EOSCogniton/Dashboard_controler/Shield carte avant/CANdiy-Shield/hardware/CANdiy-Shield_v13.jpg

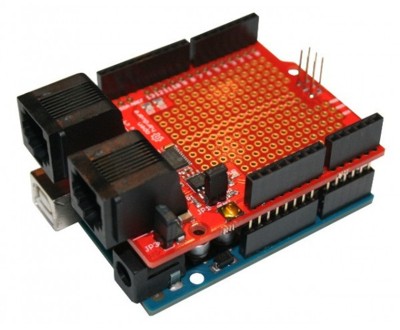
Shield carte avant/CANdiy-Shield/hardware/CANdiy-Shield_v13.jpg
