EOSCogniton/Dashboard_controler/readme.md

# Dashboard controller

* Shield pour Arduino Uno
* Pour le tableau de bord d'OPTIMUS v1.0

## Utilité :
* Transfert le CAN à l'arduino
* Contrôle les boutons lumineux en 12V
* Créer le 5V de puissance pour le tableau de bord
* Permet de se connecter avec des connecteurs molex KK à l'arduino
