EOSCogniton/Dashboard_controler/Shield carte avant/BOM_shield carte avant.xlsx

Qty | Value | Device | Description | Dispo au garage ? | Référence RS |  | oui
2 |  | 2N7000_TO92 | 2N7000, 2N7002, NDS7002A | oui | 671-4733 |  | non
1 |  | SWITCH_PUSHBUTTONEVQ-PE | Buttons | non | 734-6823 |  | Je sais pas
3 | 1 µF | CPOL-EUB45181A | POLARIZED CAPACITOR, European symbol | oui
2 | 100 | R-EU_0204/7 | RESISTOR, European symbol | oui
1 | 100k | R-EU_0204/7 | RESISTOR, European symbol | oui
2 | 10k | R-EU_0204/7 | RESISTOR, European symbol | oui
1 | 120 | R-EU_0204/7 | RESISTOR, European symbol | oui
3 | 1k | R-EU_0204/7 | RESISTOR, European symbol | oui
2 | 22-05-7028-02 | 22-05-7028-02 | CONNECTOR | Je sais pas | 173-2916
1 | 22-05-7038-03 | 22-05-7038-03 | CONNECTOR | Je sais pas | 173-2922
1 | 22-05-7078-07 | 22-05-7078-07 | CONNECTOR | Je sais pas | 173-2972
3 | 27pF | C-EU025-030X050 | CAPACITOR, European symbol | oui
2 | 680 pF | C-EU025-024X044 | CAPACITOR, European symbol | Je sais pas
1 | ARDUINO_R3_ICSP | ARDUINO_R3_ICSP | Arduino Uno | non | 769-7409
1 | FOXSLF_160-20 | FOXSLF_160-20 | Crystal 16.000MHz | non | 547-6294
1 | MCP2515-I_P | MCP2515-I_P | Stand-Alone CAN Controller | non | 628-3532
1 | MCP2562-E_P | MCP2562-E_P | CAN Transceiver | non | 799-0225 | 2N700
1 | THN_15-1211 | THN_15-1211 | TRACOPOWER Isolated DC-DC Converter | non | 438-272
