EOSCogniton/Dashboard_controler/Shield carte avant/CANdiy-Shield/hardware/CANdiy-FD-Shield_v11.pdf

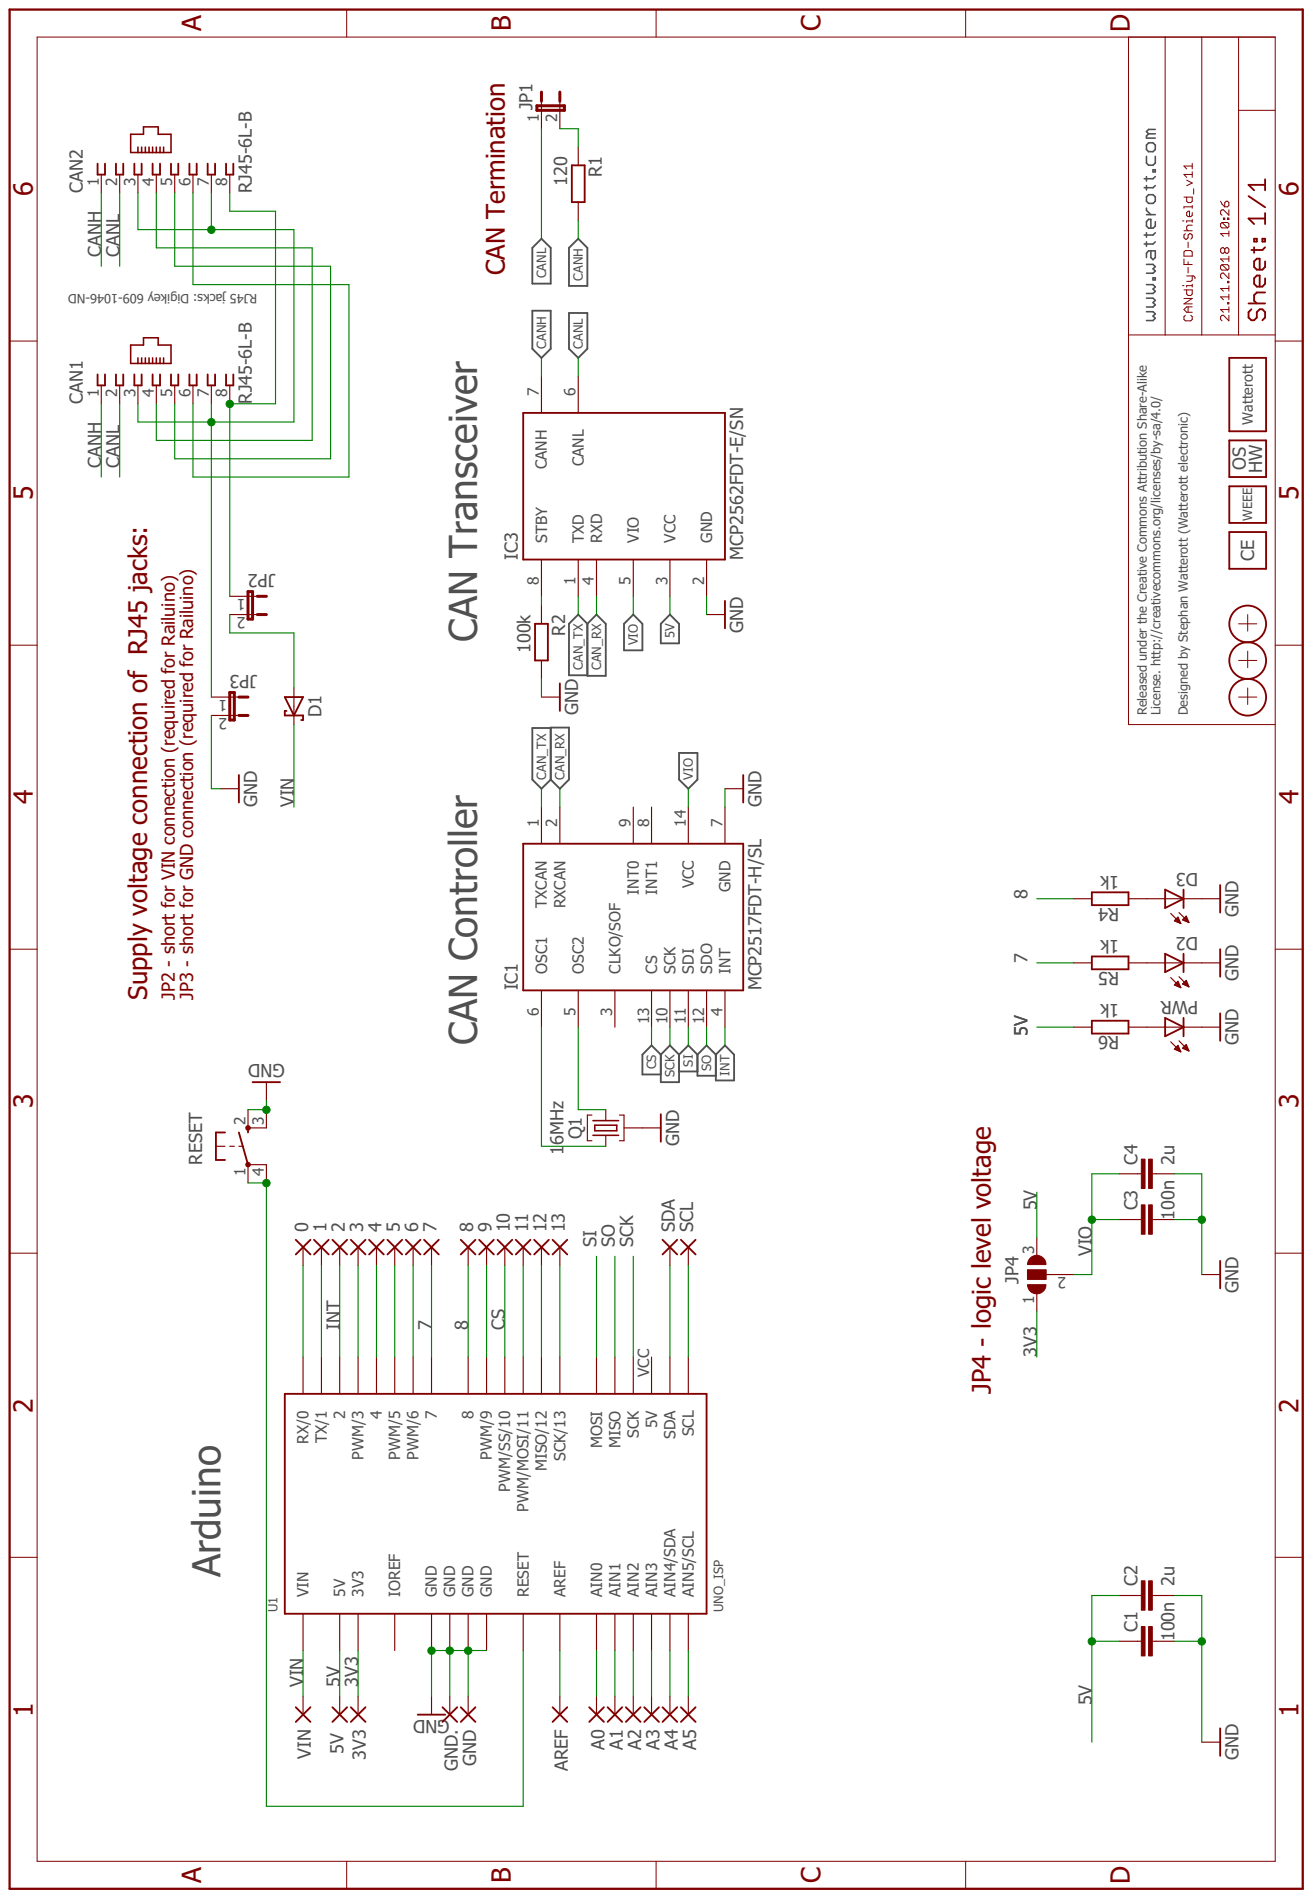
[picture p2: page 1]

DN- 6401- 906 yeki gi D:skcaj 54J RDNG DNG GND 120 RJ45-6L-B RJ45-6L-B 100n 2u GND 100k GND GND k1 GND k1 GND k1 GND 100n GND 2u GND GND 16MHz Released under the Creative Commons Attribution Share-Alike License. http://creativecommons.org/licenses/by-sa/4.0/ Designed by Stephan Watterott (Watterott electronic) Arduino CAN Controller CAN Transceiver RESET 1 23 4 R1 CAN2 12345678 CAN1 12345678 C1 C2 R2 JP1 12 2PJ 123PJ 12 012345678910111213SDA SCL A0A1A2A3A4A5 AREF VIN GND GND. 3V3 3D 4R R WP 6R 2D 5R U1UNO_ISP RX/0 TX/12 AIN0 PWM/34 PWM/5 PWM/678 PWM/9 PWM/SS/10 PWM/MOSI/11 MISO/12 SCK/13 AIN1 AIN2 AIN3 AIN4/SDA AIN5/SCL 5VVIN 3V3 AREF RESET SDA SCL IOREF GND GND GND MOSI MISO SCK GND 5V VCC C3 3 1 2 JP4 C4 Watterott CE OS HW WEEE IC3 MCP2562FDT-E/SN CANH 7 TXD 1 RXD 4 VIO 5 CANL 6 GND 2 VCC 3 STBY 8 IC1 MCP2517FDT-H/SL CS 13 SCK 10 GND 7 VCC 14 SDI 11 SDO 12 OSC2 5 OSC1 6 TXCAN 1 RXCAN 2 CLKO/SOF 3 INT0 9 INT1 8 INT 4 Q1 D1 5V 5V 5V 5V 5V 5V VIN VIN CAN_RX CAN_RX CAN_TX CAN_TX CS CS SCK SCK SI SI SO SO CANCHANH CANH CANH CANL CANL CANL CANL 8 8 INT INT 3V3 3V3 7 7 VIO VIO VIO CAN Termination Supply voltage connection of RJ45 jacks: JP3 - short for GND connection (required for Railuino) JP2 - short for VIN connection (required for Railuino) JP4 - logic level voltage ABCD 1 2 3 4 5 6 ABCD 1 2 3 4 5 6

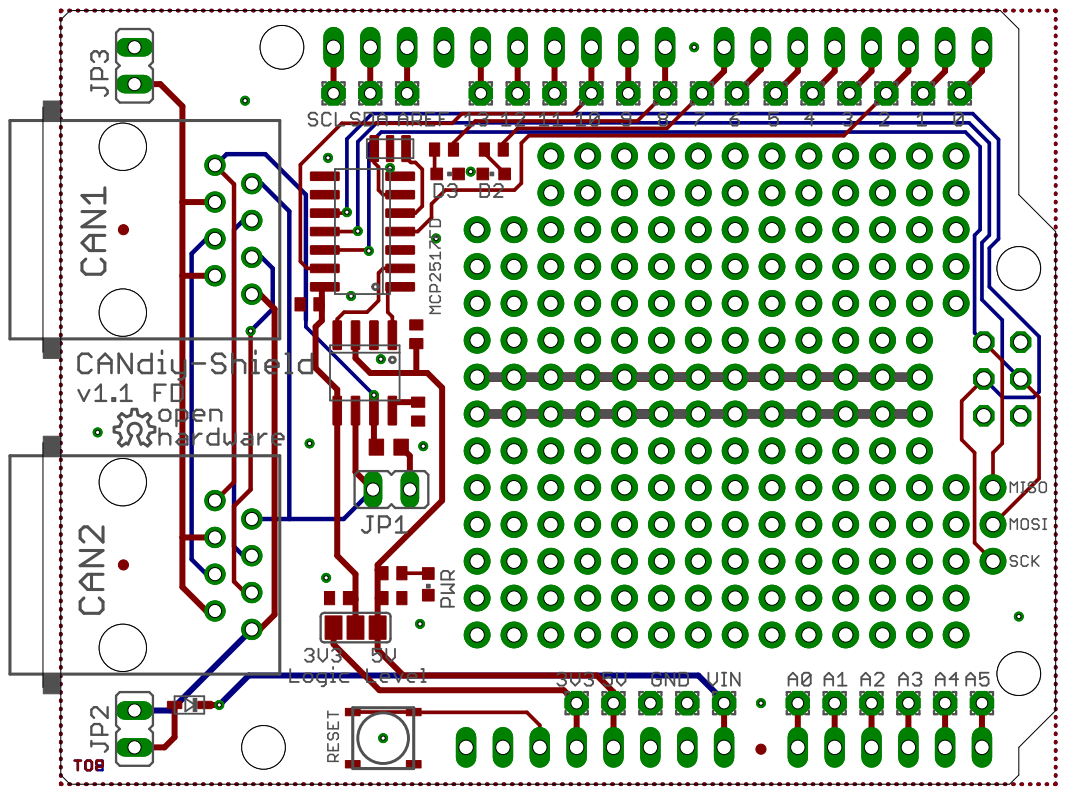
[picture p3: page 2]
