EOSCogniton/Dashboard_controler/Shield carte avant/CANdiy-Shield/hardware/CANdiy-Shield_v20.pdf

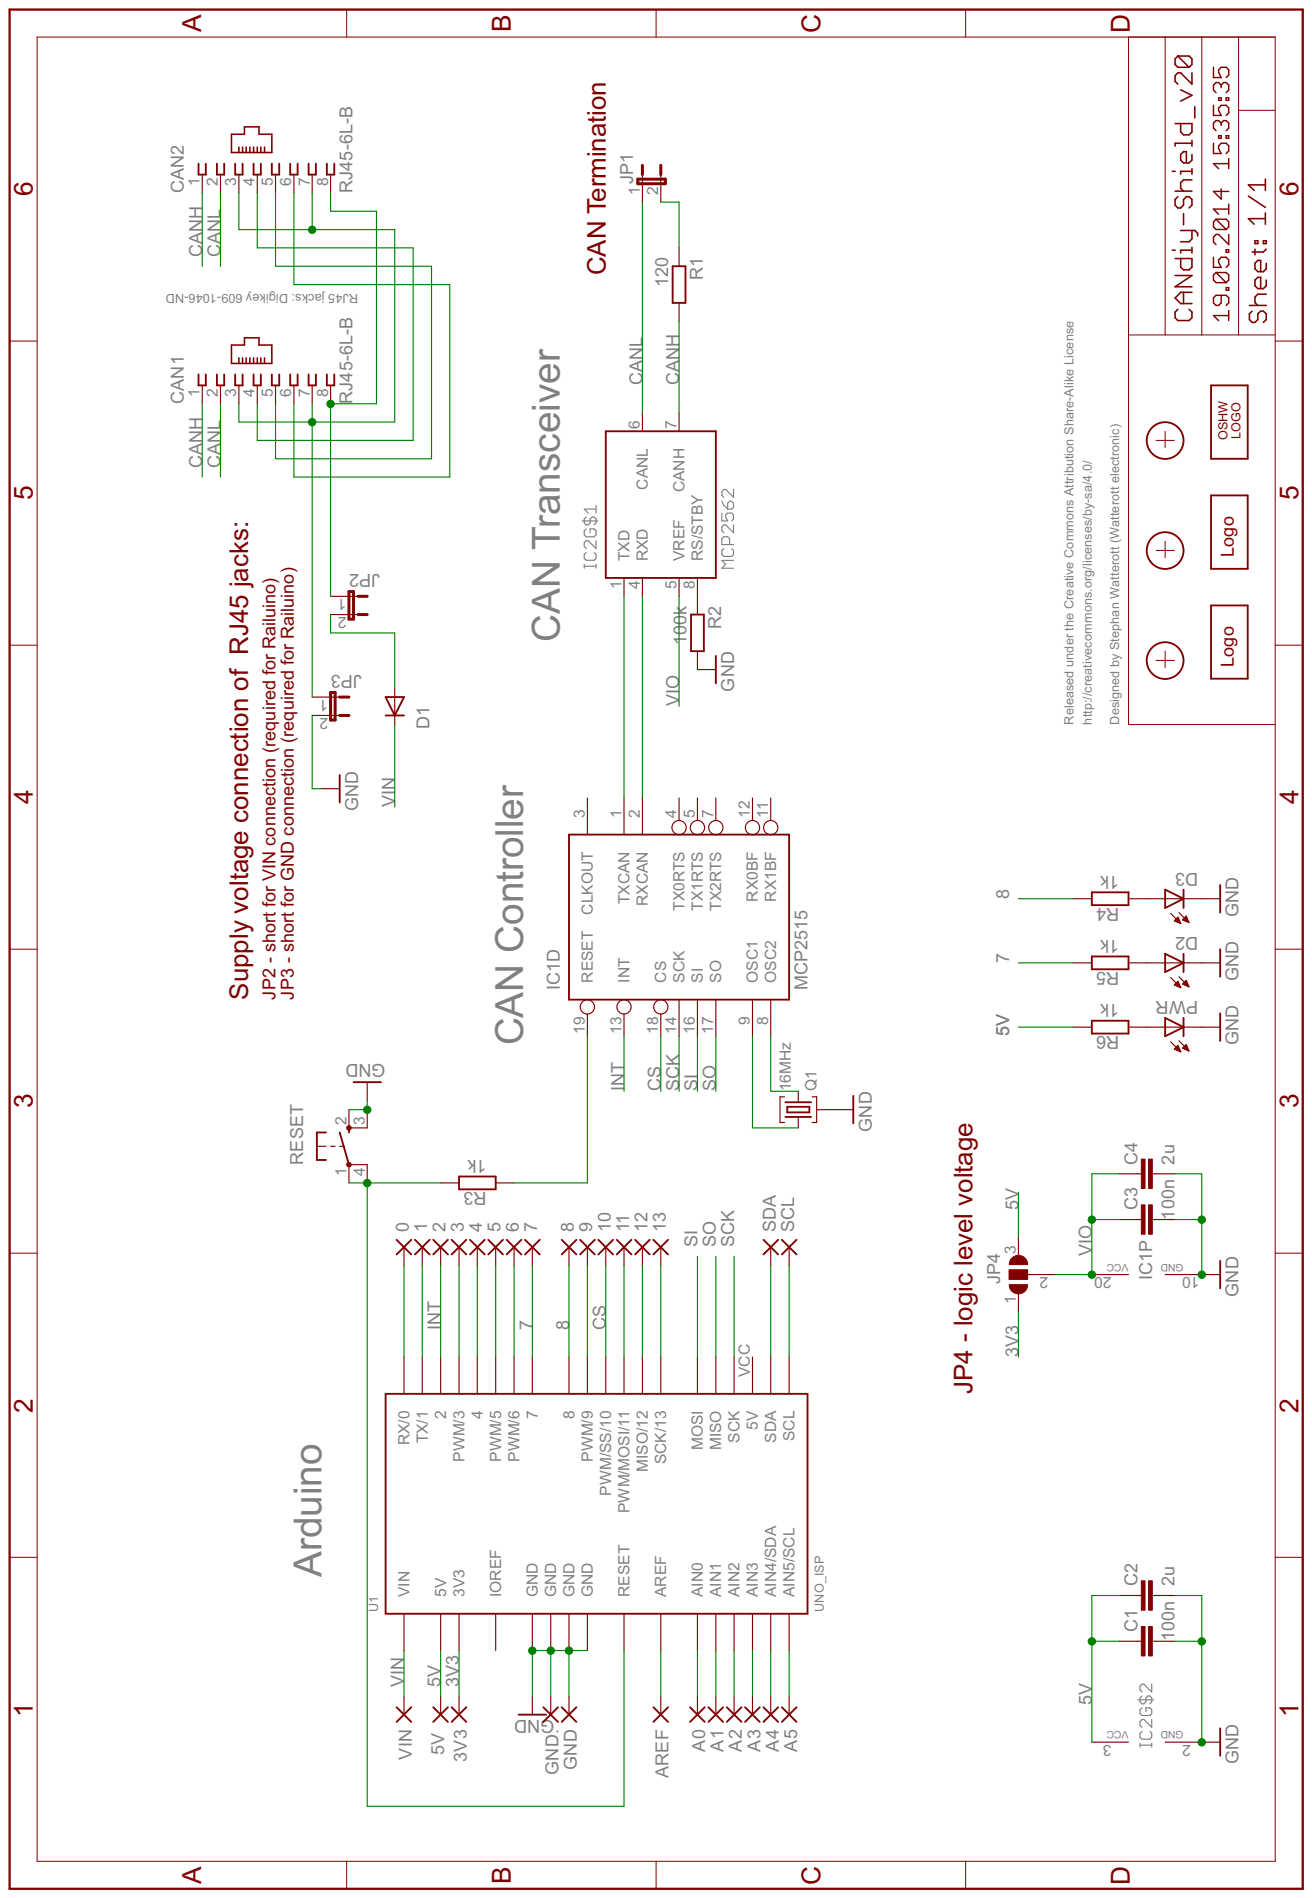
[picture p4: page 1]

DN- 6401- 906 yeki gi D: skcaj 54J RDNG DNG GND 120 RJ45-6L-B RJ45-6L-B 100n 2u GND 100k GND GNDk1 GNDk1 GNDk1 GND 16MHz MCP2515 100n GND 2uk1 Released under the Creative Commons Attribution Share-Alike License http://creativecommons.org/licenses/by-sa/4.0/ Designed by Stephan Watterott (Watterott electronic) Arduino CAN Controller CAN Transceiver /STBY RESET 1 23 4 CANH 7 CANL 6 RS 8 RXD 4 TXD 1 VREF 5 CCV DNG 3 2 R1 CAN2 12345678 CAN1 12345678 C1 C2 R2 JP1 12 2PJ 123PJ 12 012345678910111213SDA SCL A0A1A2A3A4A5 AREF VIN GND GND. 3V3 3D 4R R WP 6R 2D 5R D1 U1 UNO_ISP RX/0 TX/12 AIN0 PWM/34 PWM/5 PWM/678 PWM/9 PWM/SS/10 PWM/MOSI/11 MISO/12 SCK/13 AIN1 AIN2 AIN3 AIN4/SDA AIN5/SCL 5VVIN 3V3 AREF RESET SDA SCL IOREF GND GND GND MOSI MISO SCK GND 5V VCC Q1 IC1D CLKOUT 3 CS 18 INT 13 OSC1 9 OSC2 8 RESET 19 RX0BF 12 RX1BF 11 RXCAN 2 SCK 14 SI 16 SO 17 TX0RTS 4 TX1RTS 5 TX2RTS 7 TXCAN 1 CCV DNG IC1P 02 01 C3 3 1 2 JP4 C4 3R 5V 5V 5V 5V 5V VIN VIN CS CS SCK SCK SI SI SO SO CANH CANH CANH CANL CANL CANL 8 8 INT INT 3V3 3V3 7 7 VIO VIO CAN Termination Supply voltage connection of RJ45 jacks: JP3 - short for GND connection (required for Railuino) JP2 - short for VIN connection (required for Railuino) JP4 - logic level voltage ABCD 1 2 3 4 5 6 ABCD 1 2 3 4 5 6 OSHW LOGO Logo Logo

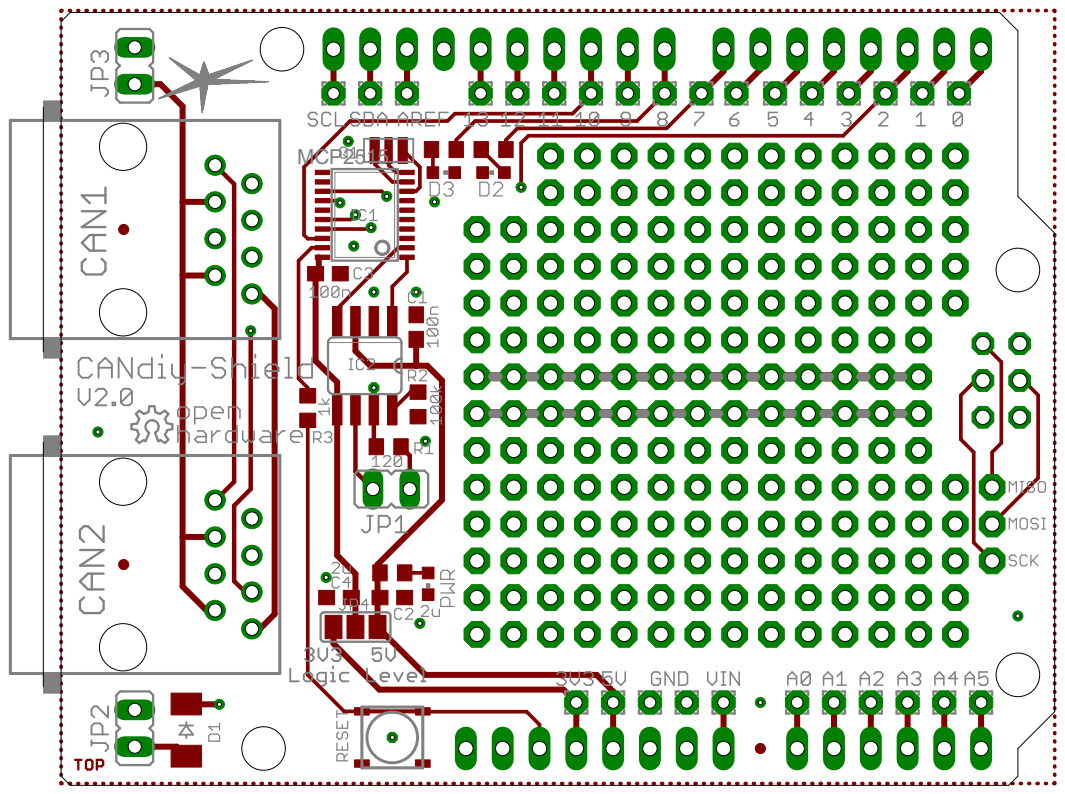
[picture p5: page 2]
MCP2515

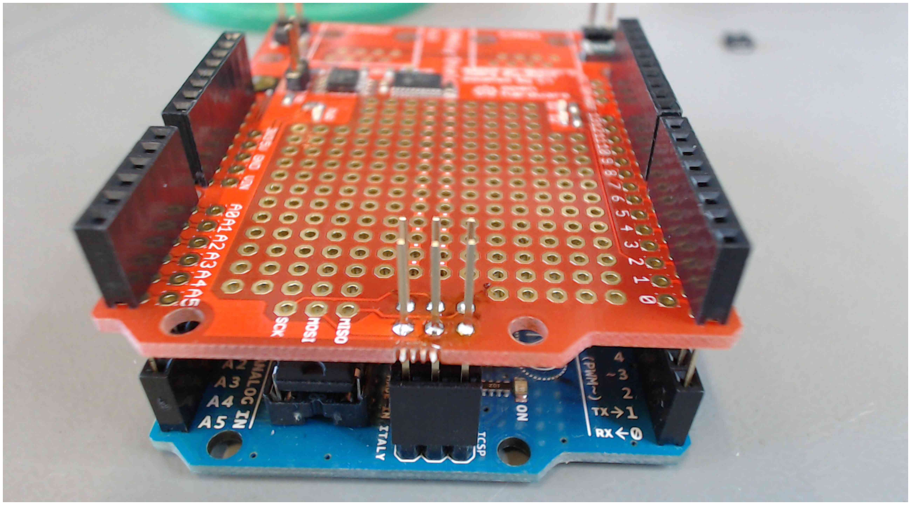
[picture p6: figure]
