EOSCogniton/Dashboard_controler/Shield carte avant/CANdiy-Shield/hardware/CANdiy-Shield_v12.pdf

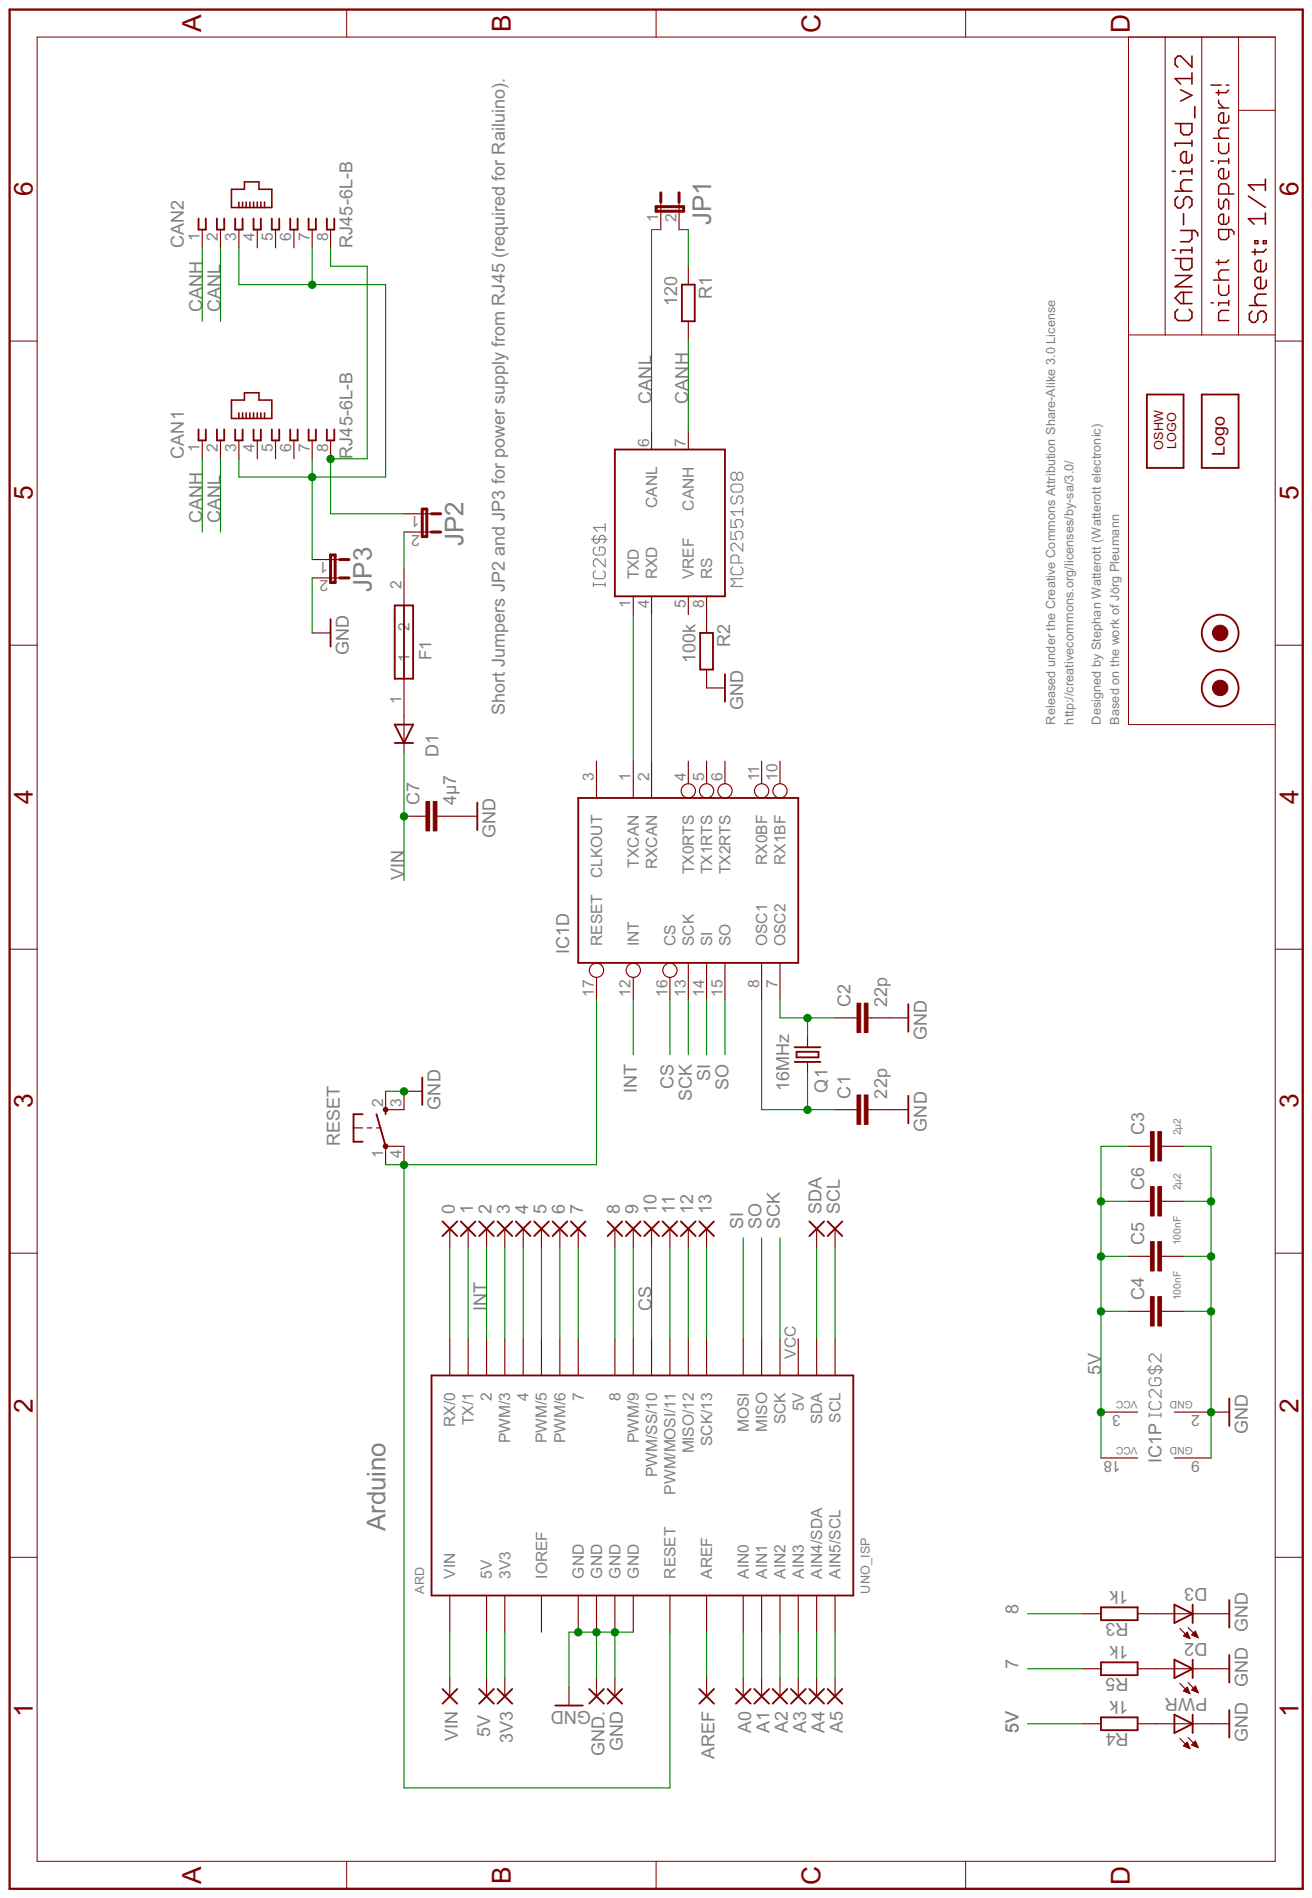
[picture p7: page 1]

GND GND 120 RJ45-6L-B RJ45-6L-B 16MHz 22p 22p 2µ2 100nF 100nF 2µ2 GND GND 100k GND DNG GNDk1 GNDk1 GNDk1 4µ7 GND GND Released under the Creative Commons Attribution Share-Alike 3.0 License http://creativecommons.org/licenses/by-sa/3.0/ Designed by Stephan Watterott (Watterott electronic) Arduino F1 Based on the work of Jörg Pleumann RESET 1 23 4 IC1D CLKOUT 3 CS 16 INT 12 OSC1 8 OSC2 7 RESET 17 RX0BF 11 RX1BF 10 RXCAN 2 SCK 13 SI 14 SO 15 TX0RTS 4 TX1RTS 5 TX2RTS 6 TXCAN 1 CANH 7 CANL 6 RS 8 RXD 4 TXD 1 VREF 5 CCV DNG 3 2 R1 CAN2 12345678 CAN1 12345678 Q1 C1 C2 C3 C4 C5 C6 CCV DNG IC1P 81 9 R2 12JP1 12 JP2 12 JP3 012345678910111213SDA SCL A0A1A2A3A4A5 AREF VIN GND GND. 3V3 3D 3R R WP 4R 2D 5R C7 D1 1 1 2 2 ARD UNO_ISP RX/0 TX/12 AIN0 PWM/34 PWM/5 PWM/678 PWM/9 PWM/SS/10 PWM/MOSI/11 MISO/12 SCK/13 AIN1 AIN2 AIN3 AIN4/SDA AIN5/SCL 5VVIN 3V3 AREF RESET SDA SCL IOREF GND GND GND MOSI MISO SCK GND 5V VCC 5V 5V 5V VIN CS CS SCK SCK SI SI SO SO CANH CANH CANH CANL CANL CANL 8 INT INT 7 ABCD 1 2 3 4 5 6 ABCD 1 2 3 4 5 6 OSHW LOGO Logo Short Jumpers JP2 and JP3 for power supply from RJ45 (required for Railuino).

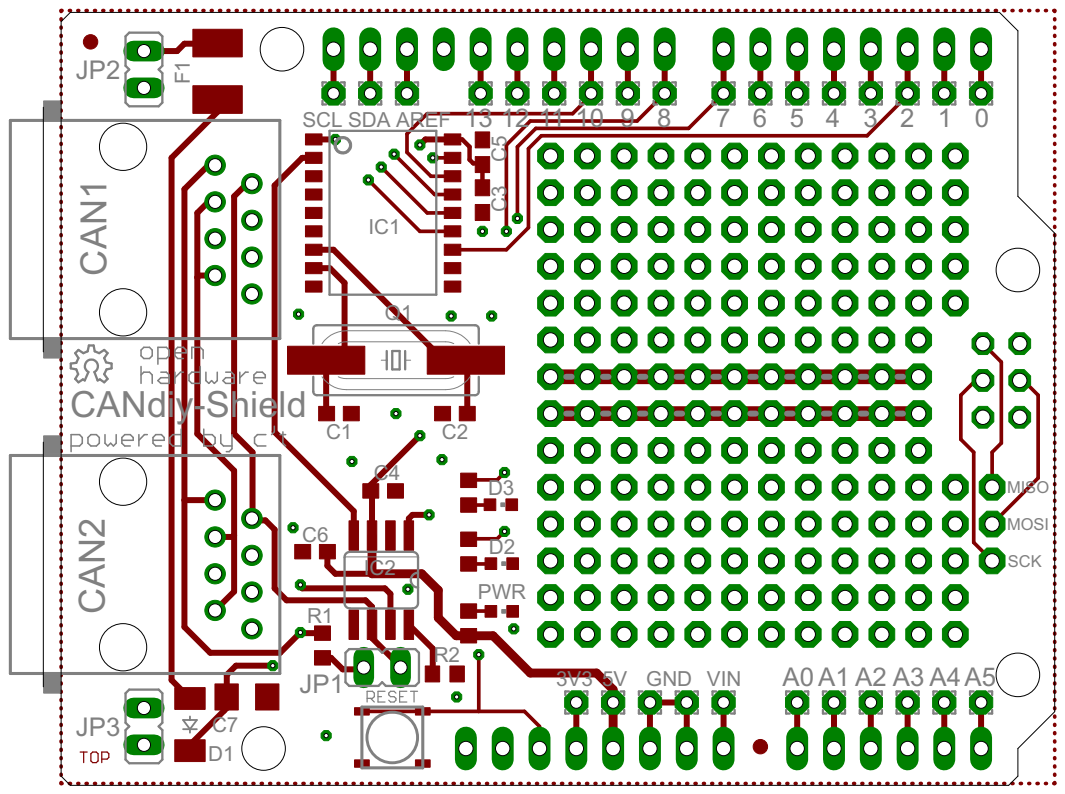
[picture p8: page 2]
