EOSCogniton/Dashboard_controler/Shield carte avant/shield carte avant.brd

## EAGLE design Shield carte avant/shield carte avant.brd (2019-01-17)

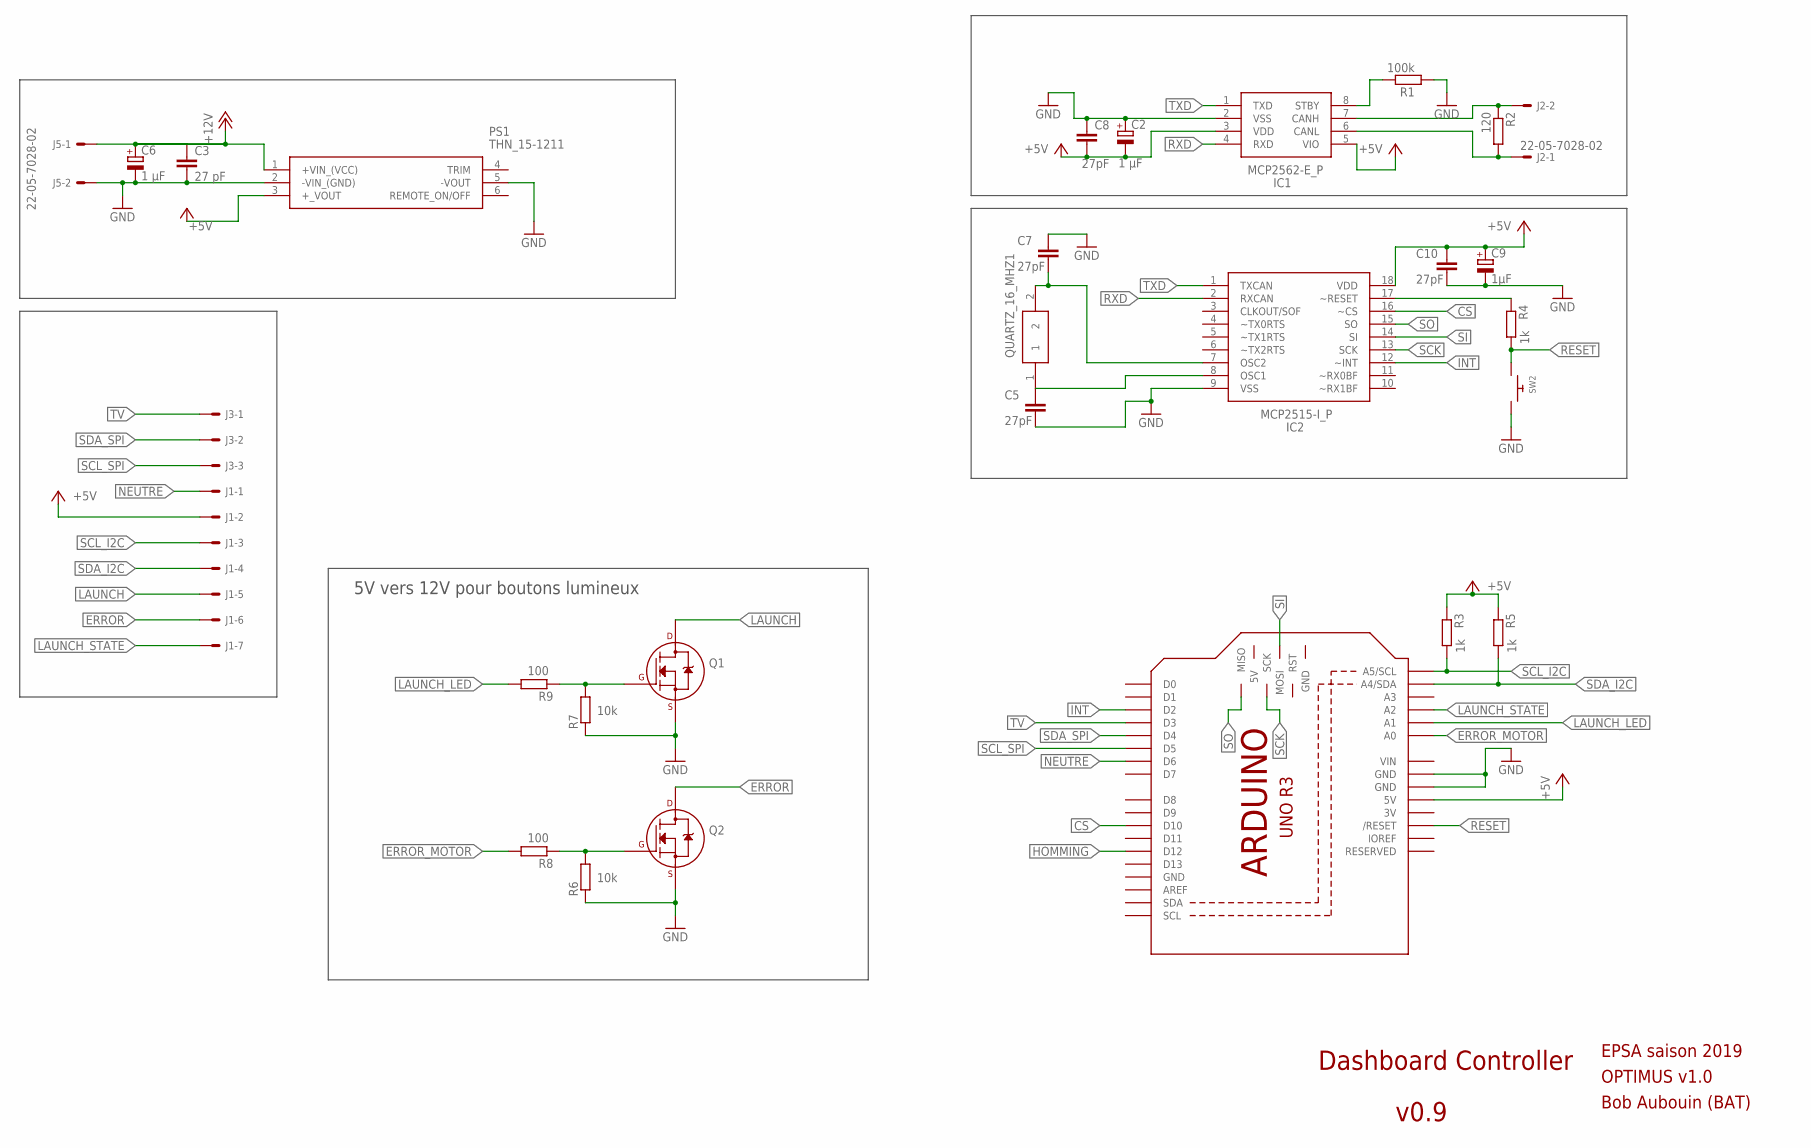
[picture p9: schematic shield carte avant.sch]

Parts:
C2, C6: 1 µF; B45181A
C3: 27 pF; C025-024X044
C5, C7, C8, C10: 27pF; C025-030X050
C9: 1µF; B45181A
IC1: MCP2562-E_P; DIP781W56P254L950H533Q8N
IC2: MCP2515-I_P; DIP254P762X432-18
J1: 22-05-7078-07; 7395-07
J2, J5: 22-05-7028-02; 7395-02
J3: 22-05-7038-03; 7395-03
M1: ARDUINO_R3_ICSP; ARDUINOR3_ICSP
PS1: THN_15-1211; THN-15-SERIES
Q1, Q2: 2N7000_TO92; TO-92
QUARTZ_16_MHZ1: FOXSLF_160-20; HC49SLF_1
R1: 100k; 0204/7
R2: 120; 0204/7
R3, R4, R5: 1k; 0204/7
R6, R7: 10k; 0204/7
R8, R9: 100; 0204/7
SW2: SWITCH_PUSHBUTTONEVQ-PE; TACT_PANA-EVQ

Connections:
3V: M1.3V
+5V: C2.-, C8.2, C9.+, C10.1, IC1.3 (VDD), IC2.18 (VDD), J1.2, M1.5V, PS1.3 (+_VOUT), R3.1, R5.1
+12V: C3.1, C6.+, J5.1, PS1.1 (+VIN_(VCC))
CS: IC2.16 (~CS), M1.D10
ERROR: J1.6, Q2.3 (D)
ERROR_MOTOR: M1.A0, R8.2
GND: C2.+, C3.2, C5.2, C6.-, C7.1, C8.1, C9.-, C10.2, IC1.2 (VSS), IC2.9 (VSS), J5.2, M1.GND, M1.GND@1 (GND), M1.GND@3 (GND), PS1.2 (-VIN_(GND)), PS1.5 (-VOUT), Q1.1 (S), Q2.1 (S), R1.1, R6.1, R7.1, SW2.P$2
HOMMING: M1.D12
INT: IC2.12 (~INT), M1.D2
LAUNCH: J1.5, Q1.3 (D)
LAUNCH_LED: M1.A1, R9.2
LAUNCH_STATE: J1.7, M1.A2
unnamed: IC1.8 (STBY), R1.2
unnamed: C5.1, IC2.8 (OSC1), QUARTZ_16_MHZ1.1
unnamed: IC1.7 (CANH), J2.2, R2.1
unnamed: C7.2, IC2.7 (OSC2), QUARTZ_16_MHZ1.2
unnamed: IC1.6 (CANL), J2.1, R2.2
unnamed: IC2.17 (~RESET), R4.1
unnamed: Q2.2 (G), R6.2, R8.1
unnamed: Q1.2 (G), R7.2, R9.1
NEUTRE: J1.1, M1.D6
RESET: M1.RESET (/RESET), R4.2, SW2.P$1
RXD: IC1.4 (RXD), IC2.2 (RXCAN)
SCK: IC2.13 (SCK), M1.SCK
SCL_I2C: J1.3, M1.A5 (A5/SCL), R3.2
SCL_SPI: J3.3, M1.D5
SDA_I2C: J1.4, M1.A4 (A4/SDA), R5.2
SDA_SPI: J3.2, M1.D4
SI: IC2.14 (SI), M1.MOSI
SO: IC2.15 (SO), M1.MISO
TV: J3.1, M1.D3
TXD: IC1.1 (TXD), IC2.1 (TXCAN)
VIN: M1.VIN

Notes on the sheet:
Dashboard Controller
v0.9
EPSA saison 2019
OPTIMUS v1.0
Bob Aubouin (BAT)
5V vers 12V pour boutons lumineux

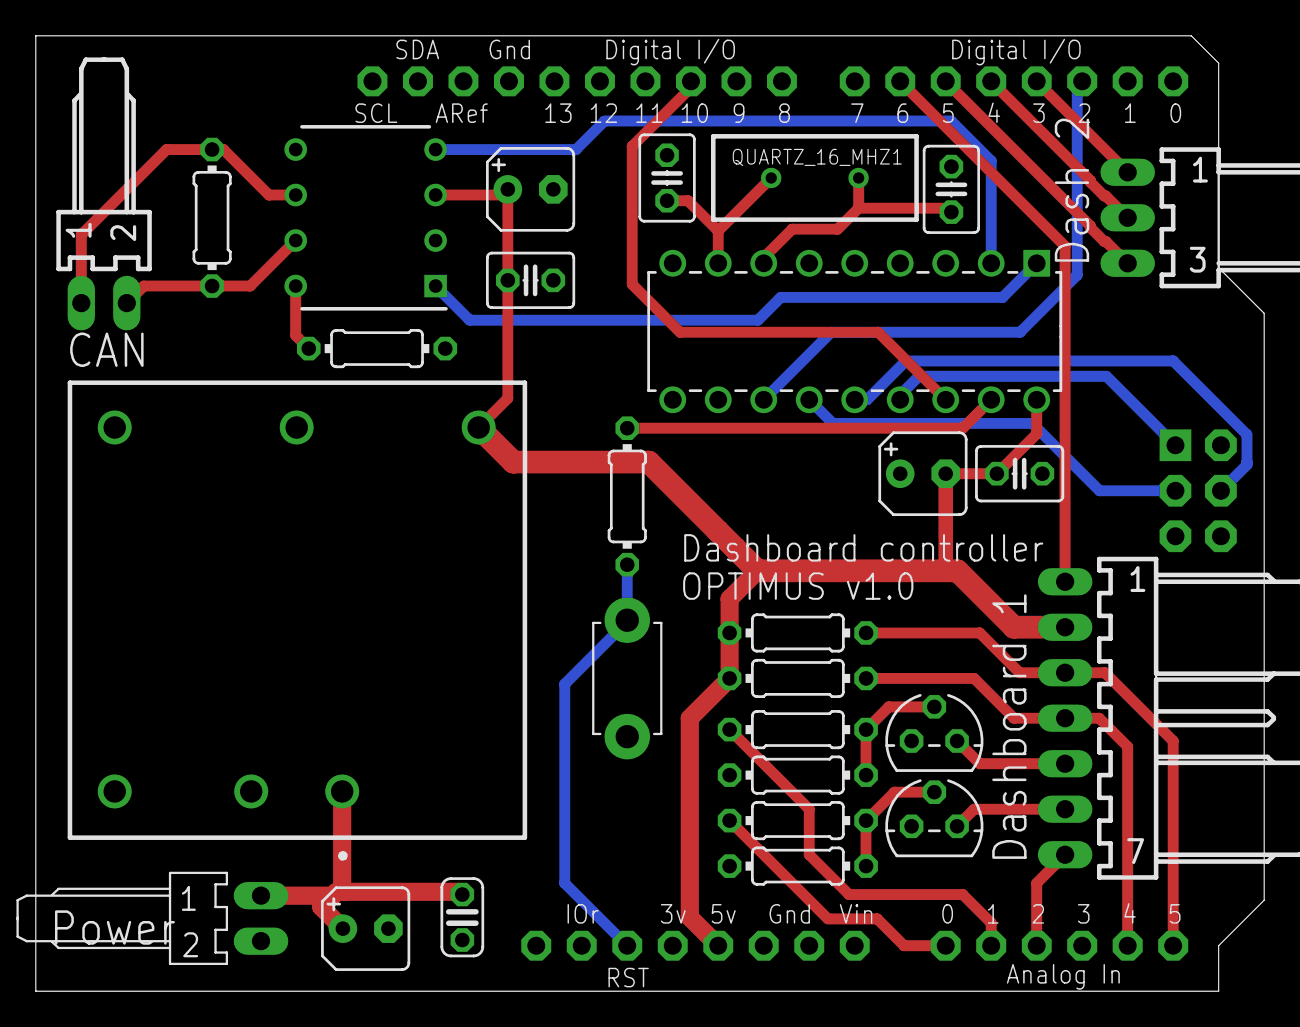
[picture p10: board shield carte avant.brd from above]

Board: 2 copper layers, 68.6 x 53.3 mm, 29 parts (0 on the bottom side), 30 nets.
