EOSCogniton/Dashboard_controler/Shield carte avant/CANdiy-Shield/hardware/CANdiy-FD-Shield_v11.brd

## EAGLE design Shield carte avant/CANdiy-Shield/hardware/CANdiy-FD-Shield_v11.brd (2019-01-17)

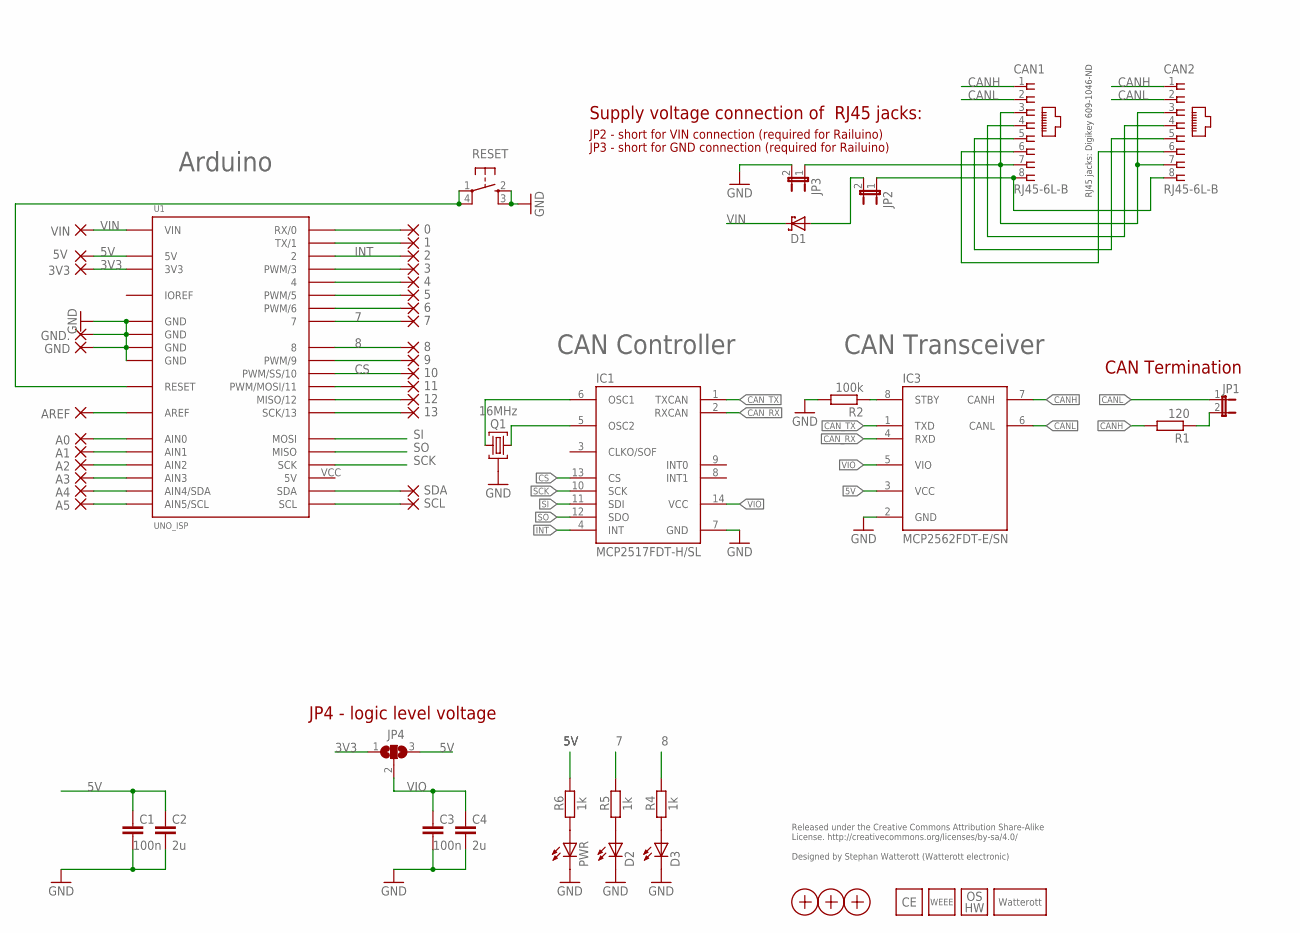
[picture p11: schematic CANdiy-FD-Shield_v11.sch]

Parts:
0, 1, 2, 3, 3V3, 4, 5, 5V, 6, 7, 8, 9, 10, 11, 12, 13: 1,6/0,8
A0, A1, A2, A3, A4, A5: 1,6/0,8
AREF: 1,6/0,8
C1, C3: 100n; C0402
C2, C4: 2u; C0402
CAN1, CAN2: RJ45-6L-B; RJ45-NO-SHIELD
D1: D_SCHOTTKY-SOD323; SOD323
D2, D3: LEDCHIPLED_0603; CHIPLED_0603
GND, GND.: 1,6/0,8
IC1: MCP2517FDT-H/SL; SO14
IC3: MCP2562FDT-E/SN; SO08
JP1, JP2, JP3: JP1E; JP1
JP4: SJ2W; SJ_2
LOGO3: LOGO-9; LOGO_9MM
LOGO4: LOGO_CE-2; CE_2MM
LOGO5: LOGO_OSHW-3; OSHW_3MM
LOGO6: LOGO_WEEE-4; WEEE_4MM
PWR: LEDCHIPLED_0603; CHIPLED_0603
Q1: 16MHz; CRYSTAL_32X13
R1: 120; R0603
R2: 100k; R0402
R4, R5, R6: 1k; R0402
RESET: SW_SMDS; SW_SMD4
SCL: 1,6/0,8
SDA: 1,6/0,8
U1: UNO_ISP
VIN: 1,6/0,8
X1, X2, X3: PASSER-07; PASSER_07MM

Connections:
0: 0.1, U1.0 (RX/0)
1: 1.1, U1.1 (TX/1)
3: 3.1, U1.3 (PWM/3)
3V3: 3V3.1, JP4.1, U1.3V3
4: 4.1, U1.4
5: 5.1, U1.5 (PWM/5)
5V: 5V.1, C1.1, C2.1, IC3.3 (VCC), JP4.3, R6.1, U1.5V
6: 6.1, U1.6 (PWM/6)
7: 7.1, R5.1, U1.7
8: 8.1, R4.1, U1.8
9: 9.1, U1.9 (PWM/9)
11: 11.1, U1.11 (PWM/MOSI/11)
12: 12.1, U1.12 (MISO/12)
13: 13.1, U1.13 (SCK/13)
A0: A0.1, U1.AIN0
A1: A1.1, U1.AIN1
A2: A2.1, U1.AIN2
A3: A3.1, U1.AIN3
A4: A4.1, U1.AIN4 (AIN4/SDA)
A5: A5.1, U1.AIN5 (AIN5/SCL)
AREF: AREF.1, U1.AREF
CANH: CAN1.1, CAN2.1, IC3.7 (CANH), R1.2
CANL: CAN1.2, CAN2.2, IC3.6 (CANL), JP1.1
CAN_RX: IC1.2 (RXCAN), IC3.4 (RXD)
CAN_TX: IC1.1 (TXCAN), IC3.1 (TXD)
CS: 10.1, IC1.13 (CS), U1.10 (PWM/SS/10)
GND: C1.2, C2.2, C3.2, C4.2, D2.C, D3.C, GND.1, GND..1, IC1.7 (GND), IC3.2 (GND), JP3.2, PWR.C, Q1.GND, R2.2, RESET.2 (S), RESET.3 (S1), U1.GND@1 (GND), U1.GND@2 (GND), U1.GND@3 (GND), U1.GND@4 (GND)
INT: 2.1, IC1.4 (INT), U1.2
IOREF: U1.IOREF
unnamed: CAN1.8, CAN2.8, JP2.1
unnamed: IC3.8 (STBY), R2.1
unnamed: CAN1.3, CAN1.7, CAN2.3, CAN2.7, JP3.1
unnamed: JP1.2, R1.1
unnamed: SCL.1, U1.SCL
unnamed: SDA.1, U1.SDA
unnamed: D3.A, R4.2
unnamed: PWR.A, R6.2
unnamed: D2.A, R5.2
unnamed: D1.A, JP2.2
unnamed: CAN1.4, CAN2.4
unnamed: CAN1.5, CAN2.5
unnamed: CAN1.6, CAN2.6
OSC1: IC1.6 (OSC1), Q1.2
OSC2: IC1.5 (OSC2), Q1.1
RESET: RESET.1, RESET.4 (P1), U1.RST (RESET)
SCK: IC1.10 (SCK), U1.SCK
SI: IC1.11 (SDI), U1.MOSI
SO: IC1.12 (SDO), U1.MISO
VIN: D1.C, U1.VIN, VIN.1
VIO: C3.1, C4.1, IC1.14 (VCC), IC3.5 (VIO), JP4.2

Notes on the sheet:
Released under the Creative Commons Attribution Share-Alike License. http://creativecommons.org/licenses/by-sa/4.0/ Designed by Stephan Watterott (Watterott electronic)
Arduino
CAN Termination
Supply voltage connection of RJ45 jacks:
JP3 - short for GND connection (required for Railuino)
JP2 - short for VIN connection (required for Railuino)
RJ45 jacks: Digikey 609-1046-ND
CAN Controller
CAN Transceiver
JP4 - logic level voltage

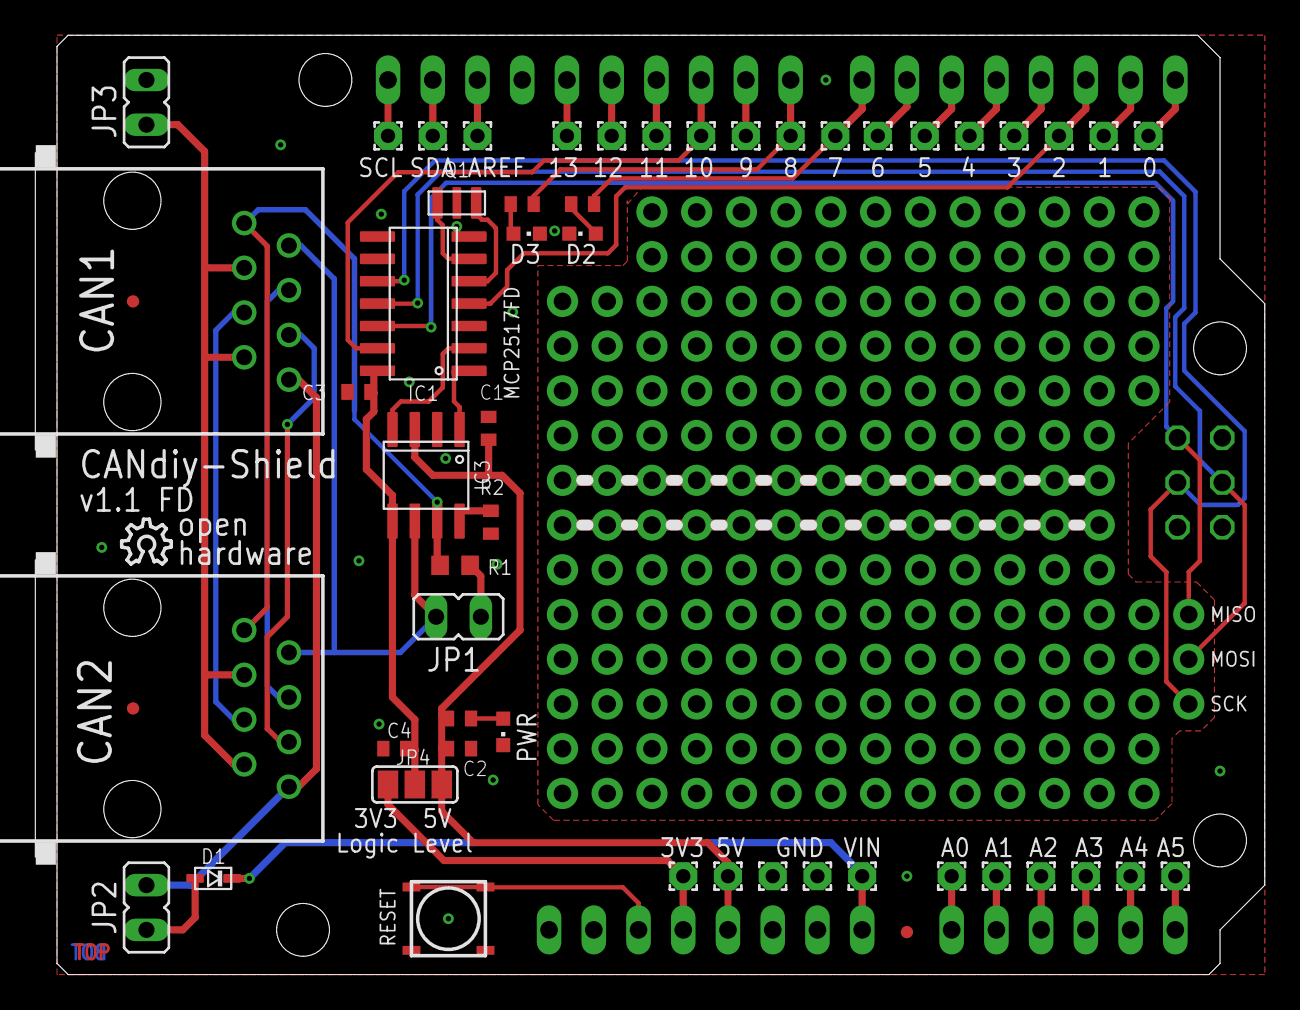
[picture p12: board CANdiy-FD-Shield_v11.brd from above]

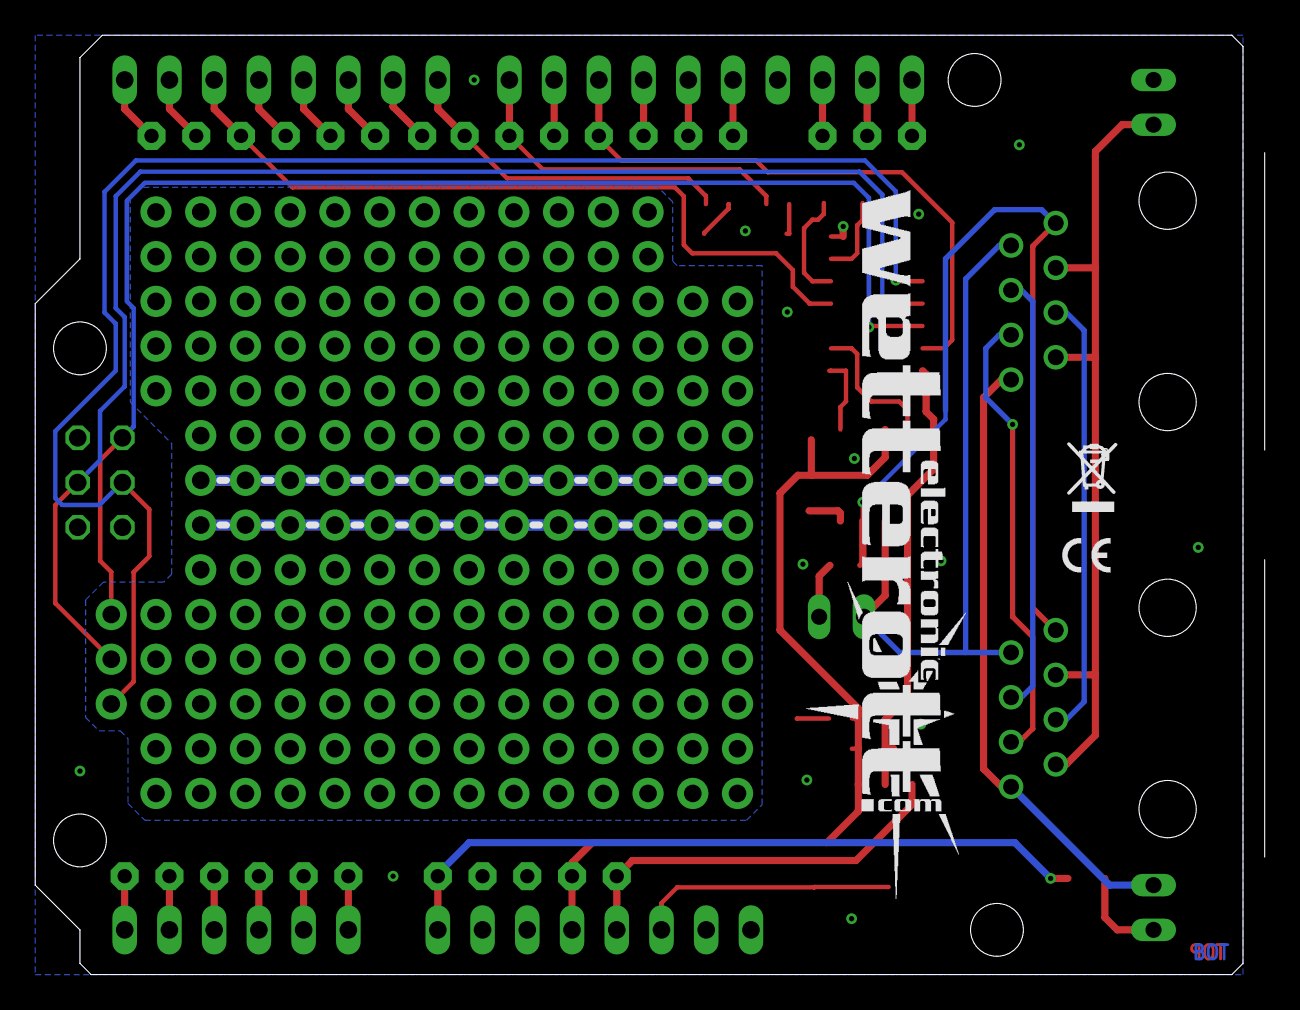
[picture p13: board CANdiy-FD-Shield_v11.brd from below]

Board: 2 copper layers, 69.8 x 53.3 mm, 59 parts (3 on the bottom side), 49 nets.
