EOSCogniton/Dashboard_controler/Shield carte avant/CANdiy-Shield/hardware/CANdiy-Shield_v12.brd

## EAGLE design Shield carte avant/CANdiy-Shield/hardware/CANdiy-Shield_v12.brd (2019-01-17, an earlier design)

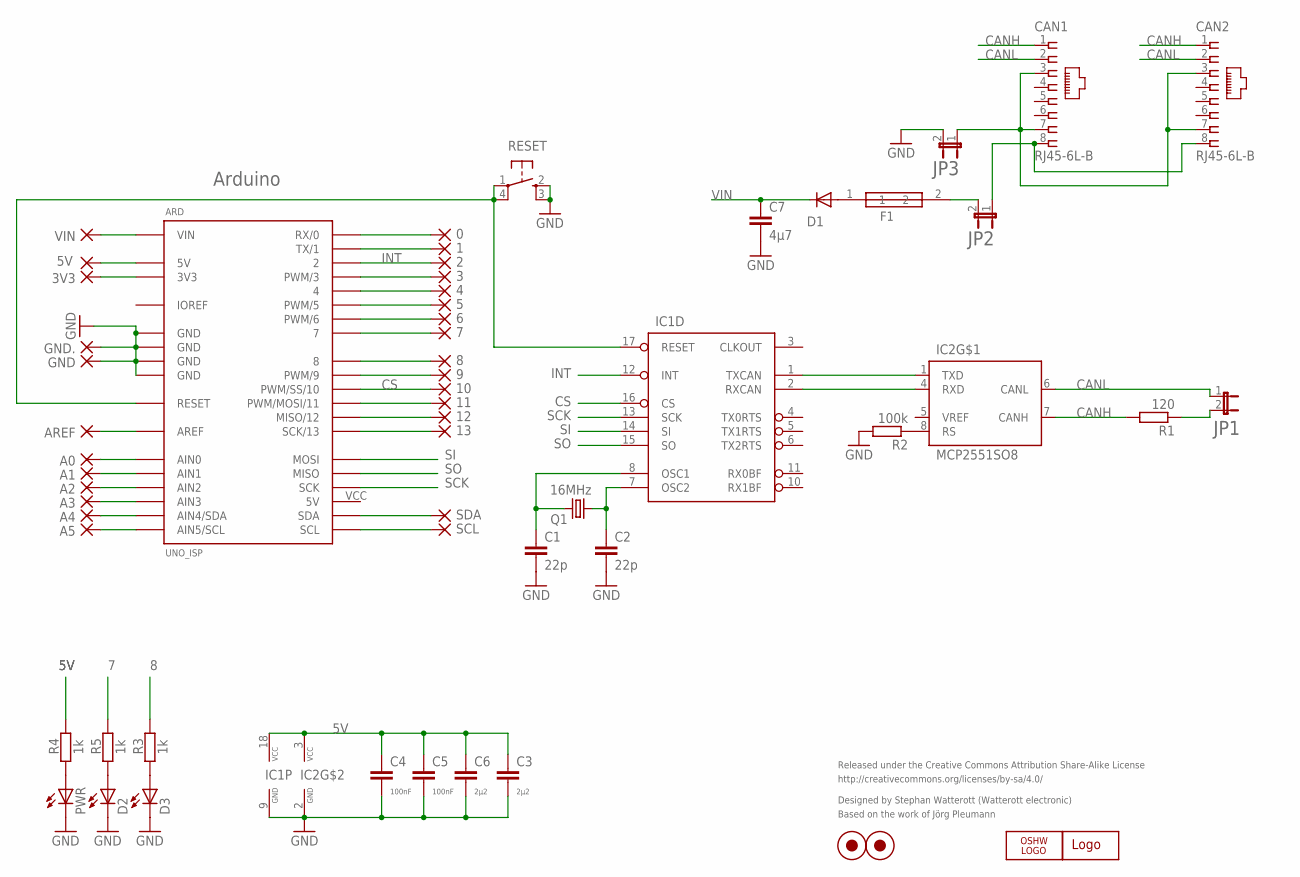
[picture p14: schematic CANdiy-Shield_v12.sch]

Parts:
0, 1, 2, 3, 3V3, 4, 5, 5V, 6, 7, 8, 9, 10, 11, 12, 13: 1,6/0,8
A0, A1, A2, A3, A4, A5: 1,6/0,8
ARD: UNO_ISP
AREF: 1,6/0,8
C1, C2: 22p; C0603
C3, C6: 2µ2; C0603
C4, C5: 100nF; C0603
C7: 4µ7; C1206
CAN1, CAN2: RJ45-6L-B; RJ45-NO-SHIELD
D1: CGRM4001-G; SOD-123_MINI-SMA
D2, D3: LEDCHIPLED_0603; CHIPLED_0603
F1: F1; L1812
GND, GND.: 1,6/0,8
IC1: MCP2515SO; SO-18W
IC2: MCP2551SO8; SO08
JP1, JP2, JP3: JP1E; JP1
LOGO2: OSHW_LOGO_6MILX0100-NT; OSHW_6X100_NOTEXT
PWR: LEDCHIPLED_0603; CHIPLED_0603
Q1: 16MHz; HC49UP
R1: 120; R0603
R2: 100k; R0603
R3, R4, R5: 1k; R0603
RESET: SW_SMDS; SW_SMD4
SCL: 1,6/0,8
SDA: 1,6/0,8
U$1: WE-LOGO
VIN: 1,6/0,8
X_1, X_2: PASS_1MM; ROUND_1MM

Connections:
3V3: 3V3.1, ARD.3V3
5V: 5V.1, ARD.5V, C3.1, C4.1, C5.1, C6.1, IC1.18 (VCC), IC2.3 (VCC), R4.1
7: 7.1, ARD.7, R5.1
8: 8.1, ARD.8, R3.1
9: 9.1, ARD.9 (PWM/9)
A0: A0.1, ARD.AIN0
AERF: ARD.AREF, AREF.1
CANH: CAN1.1, CAN2.1, IC2.7 (CANH), R1.2
CANL: CAN1.2, CAN2.2, IC2.6 (CANL), JP1.1
CS: 10.1, ARD.10 (PWM/SS/10), IC1.16 (CS)
GND: ARD.GND@1 (GND), ARD.GND@2 (GND), ARD.GND@3 (GND), ARD.GND@4 (GND), C1.2, C2.2, C3.2, C4.2, C5.2, C6.2, C7.2, D2.C, D3.C, GND.1, GND..1, IC1.9 (GND), IC2.2 (GND), JP3.2, PWR.C, R2.2, RESET.2 (S), RESET.3 (S1)
INT: 2.1, ARD.2, IC1.12 (INT)
IOREF: ARD.IOREF
unnamed: C2.1, IC1.7 (OSC2), Q1.1
unnamed: C1.1, IC1.8 (OSC1), Q1.2
unnamed: CAN1.8, CAN2.8, JP2.1
unnamed: IC2.8 (RS), R2.1
unnamed: CAN1.3, CAN1.7, CAN2.3, CAN2.7, JP3.1
unnamed: JP1.2, R1.1
unnamed: ARD.SCL, SCL.1
unnamed: ARD.SDA, SDA.1
unnamed: D3.A, R3.2
unnamed: PWR.A, R4.2
unnamed: D2.A, R5.2
unnamed: 11.1, ARD.11 (PWM/MOSI/11)
unnamed: 12.1, ARD.12 (MISO/12)
unnamed: 13.1, ARD.13 (SCK/13)
unnamed: 6.1, ARD.6 (PWM/6)
unnamed: 5.1, ARD.5 (PWM/5)
unnamed: 4.1, ARD.4
unnamed: 3.1, ARD.3 (PWM/3)
unnamed: 1.1, ARD.1 (TX/1)
unnamed: 0.1, ARD.0 (RX/0)
unnamed: A1.1, ARD.AIN1
unnamed: A2.1, ARD.AIN2
unnamed: A3.1, ARD.AIN3
unnamed: A4.1, ARD.AIN4 (AIN4/SDA)
unnamed: A5.1, ARD.AIN5 (AIN5/SCL)
unnamed: D1.A, F1.1
unnamed: F1.2, JP2.2
RESET: ARD.RST (RESET), IC1.17 (RESET), RESET.1, RESET.4 (P1)
RXCAN: IC1.2 (RXCAN), IC2.4 (RXD)
SCK: ARD.SCK, IC1.13 (SCK)
SI: ARD.MOSI, IC1.14 (SI)
SO: ARD.MISO, IC1.15 (SO)
TXCAN: IC1.1 (TXCAN), IC2.1 (TXD)
VIN: ARD.VIN, C7.1, D1.C, VIN.1

Notes on the sheet:
Released under the Creative Commons Attribution Share-Alike License
http://creativecommons.org/licenses/by-sa/4.0/
Designed by Stephan Watterott (Watterott electronic)
Arduino
Based on the work of Jörg Pleumann

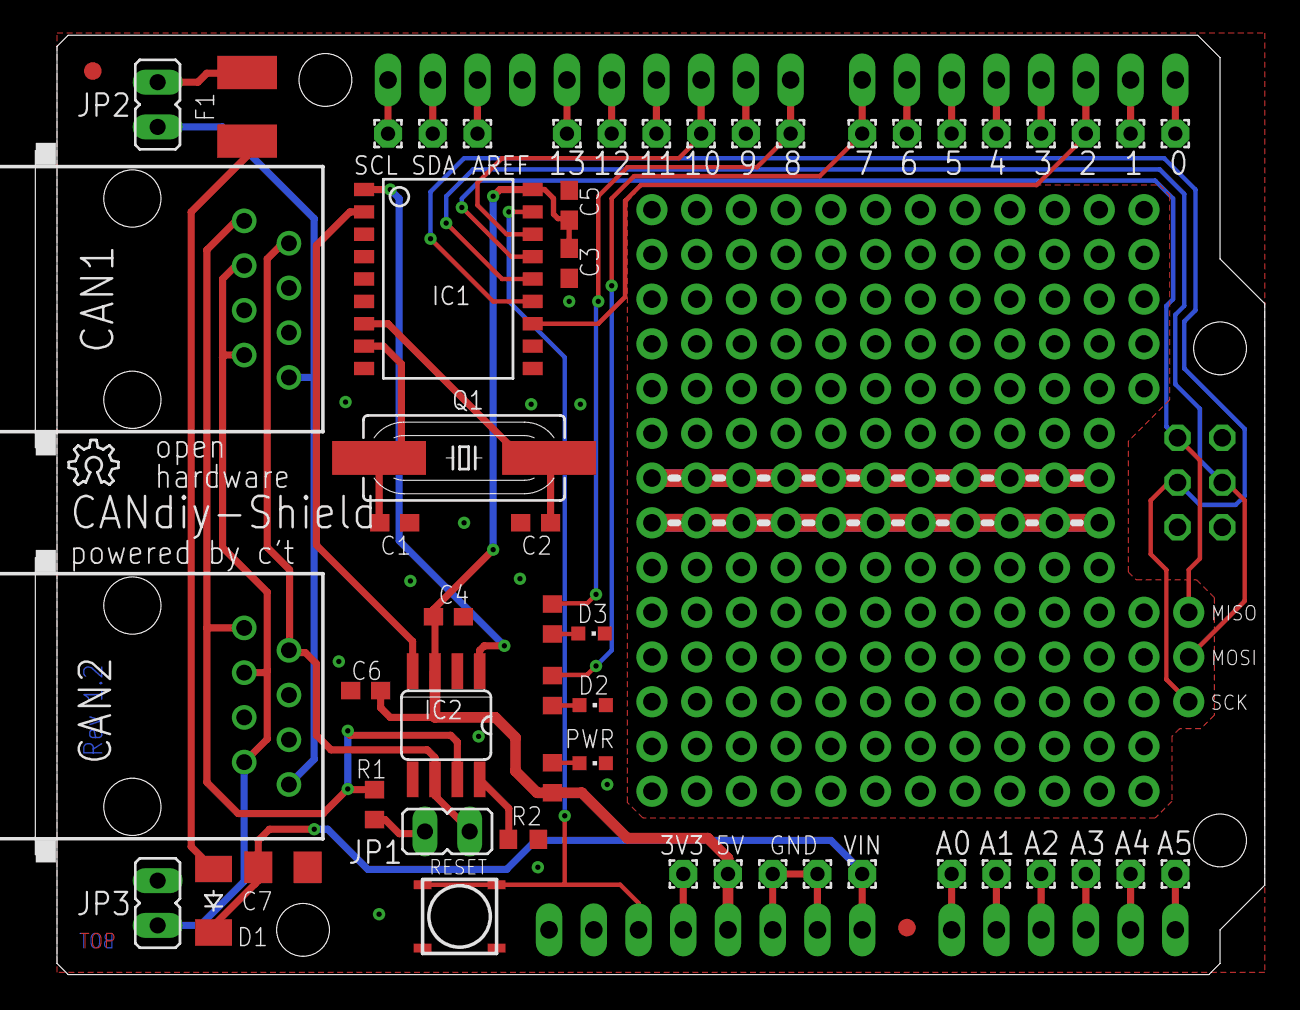
[picture p15: board CANdiy-Shield_v12.brd from above]

Board: 2 copper layers, 69.8 x 53.3 mm, 59 parts (1 on the bottom side), 46 nets.
