EOSCogniton/Dashboard_controler/(commit log)

2018-12-04 travail dèjà fait
    [Bus CAN ID List.xlsx, Lien mcp - 7 segements.xlsx, MCP2515Calc.xlsx, shield carte avant.brd, shield carte avant.sch]
2018-12-13 Déplacement de composant pour faire de la place pour les relais
    [shield carte avant.brd]
2018-12-17 Ajout de la documentation du shield CANdiy
    [CANdiy-FD-Shield_v11.brd, CANdiy-FD-Shield_v11.sch, CANdiy-Shield_v12.brd, CANdiy-Shield_v12.sch, CANdiy-Shield_v13.brd, CANdiy-Shield_v13.sch, CANdiy-Shield_v20.brd, CANdiy-Shield_v20.sch]
2018-12-17 Ajout des librairie mcp2515 et 2562 traversant
2018-12-17 Alimentation de l'arduino par le 5V, passage des ic CAN en traversant et correction du schéma CAN
    [shield carte avant.brd, shield carte avant.sch]
2018-12-17 Ajout des résistance de tirage de l'I2C
    [shield carte avant.brd, shield carte avant.sch]
2018-12-17 Ajout des nouveaux vias
    [shield carte avant.brd]
2018-12-18 Début ajout relais pour les boutons lumineux
    [shield carte avant.brd, shield carte avant.sch]
2019-01-03 Ajout des MOSFET pour gérer l'affichage des boutons
    [shield carte avant.brd, shield carte avant.sch]
2019-01-05 Fin du routage et vérification sérigraphie
    [shield carte avant.brd, shield carte avant.sch]
2019-01-13 Sérigraphie
    [shield carte avant.brd, shield carte avant.sch]
2019-01-13 Ajout BOM
    [BOM_shield carte avant.xlsx]
2019-01-17 Revue PJR
    [shield carte avant.brd, shield carte avant.sch]
2019-01-17 maj numéro de version pour release
    [shield carte avant.sch]
